ArielDcg/D_Project/Proyecto_Paint/docs/INSTRUCCIONES_OVERLEAF.md

# Instrucciones para Overleaf

## Estructura de carpetas requerida

```
proyecto/
├── informe.tex
└── img/
    ├── conexiones_fisicas.png
    ├── protocolo_ps2.png
    ├── protocolo_uart.png
    ├── datapath_uart.png
    ├── flujo_arduino_fpga.png
    ├── datapath_arduino_fpga.png
    ├── diagrama_estados_uart_arduino.png
    ├── flujo_logica_pantalla.png
    ├── datapath_ps2_to_screen.png
    ├── diagrama_estados_ps2_to_screen.png
    ├── flujo_lectura_memoria.png
    ├── datapath_lectura_memoria.png
    └── diagrama_estados_lectura_memoria.png
```

## Descarga de imágenes

Descarga las siguientes imágenes desde GitHub y guárdalas con los nombres indicados en la carpeta `img/`:

| Nombre del archivo | URL de descarga |
|---|---|
| conexiones_fisicas.png | https://github.com/user-attachments/assets/ee028650-b43a-44d6-98da-35575289e94c |
| protocolo_ps2.png | https://github.com/user-attachments/assets/46e40f8c-6ebe-4e06-9699-1737543d14f9 |
| protocolo_uart.png | https://github.com/user-attachments/assets/1425b0ae-a033-4ea5-a168-539f06cf7889 |
| datapath_uart.png | https://github.com/user-attachments/assets/e4e35282-f9b6-438d-b667-2fee0377618c |
| flujo_arduino_fpga.png | https://github.com/user-attachments/assets/b429a505-11bd-4611-87e2-851e54cfc7c7 |
| datapath_arduino_fpga.png | https://github.com/user-attachments/assets/5125b8cf-ae13-48ef-ae73-eadaf5fbb809 |
| diagrama_estados_uart_arduino.png | https://github.com/user-attachments/assets/c2bce290-ab1d-46e0-baa5-612f6f40ef66 |
| flujo_logica_pantalla.png | https://github.com/user-attachments/assets/652829d3-78c8-481e-b533-ef618b1110d9 |
| datapath_ps2_to_screen.png | https://github.com/user-attachments/assets/4b6ad8c2-2fa0-4b84-86f2-c43a5e9fd4c9 |
| diagrama_estados_ps2_to_screen.png | https://github.com/user-attachments/assets/8c0d0adb-f47a-495a-9a36-4db3aa7fd124 |
| flujo_lectura_memoria.png | https://github.com/user-attachments/assets/675c46eb-37df-4bed-a49c-1678cc857a6d |
| datapath_lectura_memoria.png | https://github.com/user-attachments/assets/1ef5d0ad-f54f-4645-99c8-c82adc4a2952 |
| diagrama_estados_lectura_memoria.png | https://github.com/user-attachments/assets/5bdc517b-2a72-470e-a508-4cb9bbcc8724 |

## Pasos en Overleaf

1. Crear un nuevo proyecto en Overleaf
2. Subir el archivo `informe.tex`
3. Crear una carpeta llamada `img`
4. Descargar cada imagen de las URLs anteriores y subirlas a la carpeta `img` con los nombres indicados
5. Compilar el documento
