ArielDcg/D_Project/(commit log)

2025-11-24 Prueba de Funcionamiento de la Calculadora
2025-12-09 Create README with project details and instructions
    Added detailed project description, team members, and usage instructions for the Paint project using PS/2 mouse, Arduino, and FPGA.
2025-12-09 Rename Video de Presentacion.mp4
2025-12-10 Arreglado sincronizacion de datos del mouse, ya pinta y se mueve correctamente
    [ctrl_paint.v, mouse_rx.v, mouse_uart.ino, paint_top.v]
2025-12-10 Ignorar archivos de síntesis de Gowin (impl/)
    [device.cfg]
2025-12-11 Agregar y corregir diagramas de interpretacion de datos para pantalla
2025-12-11 correccion de diagramas
2025-12-11 Actualizacion del diagrama de flujo de pintado de la pantalla
2025-12-11 Actualizacion de diagramas de flujo para arreglar interpretacion del movimiento del mouse en pantalla y logica de pintado
2025-12-11 arreglo del diagrama de la pantalla.
    Mala descripcion del proceso de borrado
2025-12-11 correccion diagrama logica de pantalla
2025-12-11 Correccion diagrama de flujo para pintado
2025-12-11 Correccion final diagrama de flujo para pintado
2025-12-11 Agregado diagrama estados para controlador paint
2025-12-11 Aparece el cursor y Latex
